mhenstell/pyboard/(commit log)

2014-07-15 updated pyboard to more closely resemble the newer v10 boards for which eagle files aren't available yet
    [pyboard.brd, pyboard.sch]
2014-09-26 changes from laptop
    [pyboard2.brd, pyboard2.sch]
2014-09-26 old computer changes, double check
    [pyboard.brd, pyboard.sch]
